T3P3/CurrentLoopControl/README.MD

Control of a 4-20mA current loop with optical isolation by Think3dprint3d and Escher3D

Designed to be connected to Duet Electronics. www.duet3d.com

Licensed under CERN OHL 1.2
