T3P3/CurrentLoopControl/CurrentLoopInterfaceBoard_Schematic_v0.4.pdf

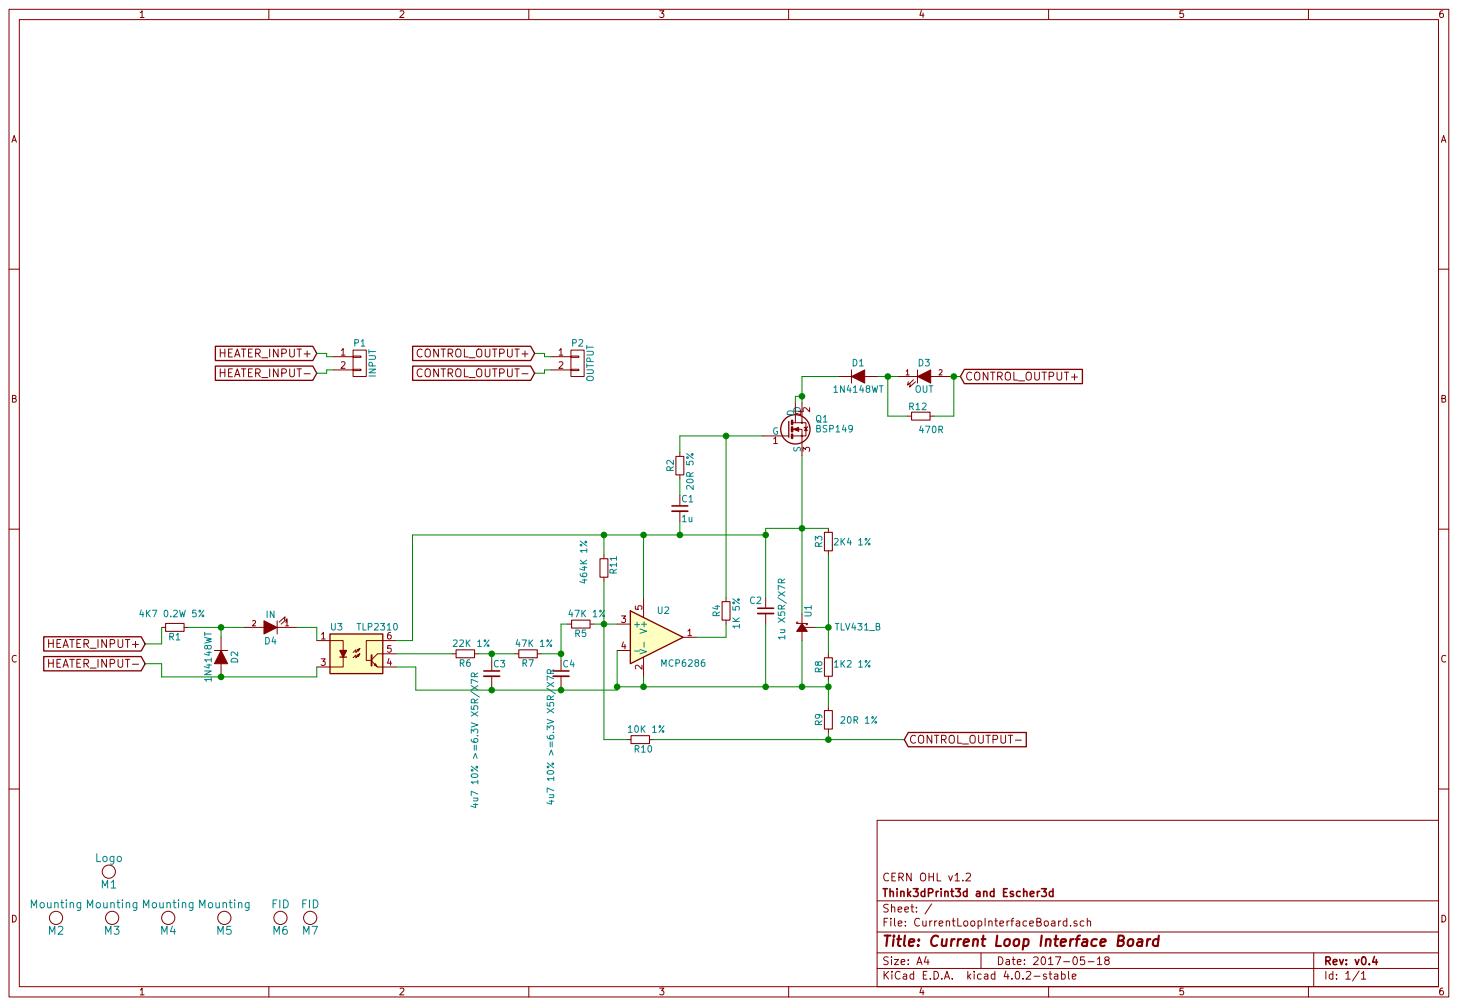
[picture p1: page 1]

File: CurrentLoopInterfaceBoard.sch Sheet: / Think3dPrint3d and Escher3d CERN OHL v1.2

Id: 1/1 Title: Current Loop Interface Board
