T3P3/CurrentLoopControl/CurrentLoopInterfaceBoard.kicad_pcb

## KiCad design CurrentLoopInterfaceBoard.kicad_pcb (2018-03-17)

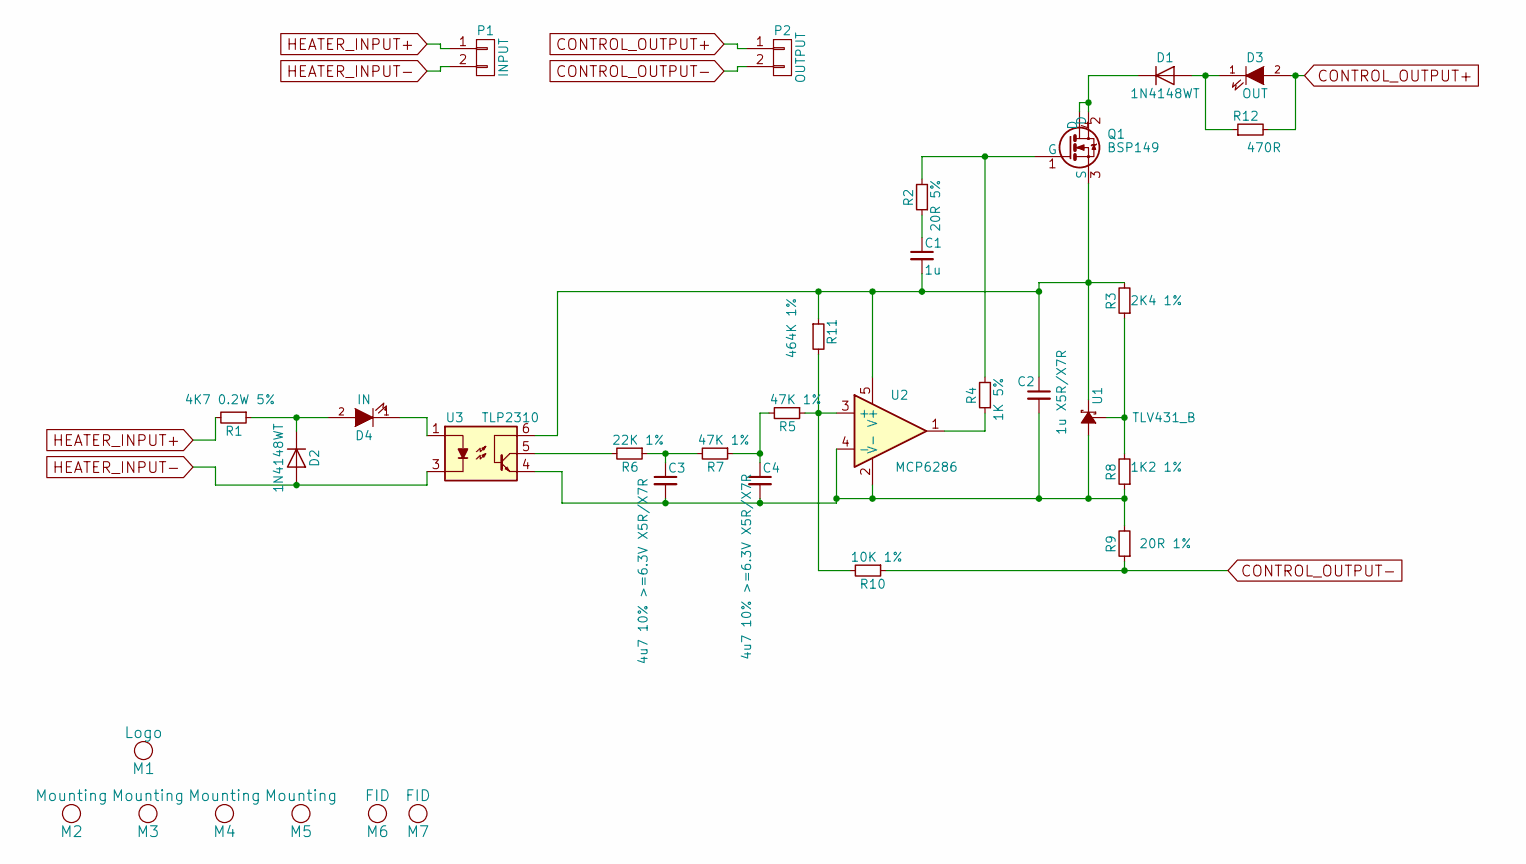
[picture p2: schematic CurrentLoopInterfaceBoard.sch, Current Loop Interface Board]

Parts:
C1: 1u; C_0603
C2: 1u X5R/X7R; C_0603
C3, C4: 4u7 10% >=6.3V X5R/X7R; C_0603
D1, D2: 1N4148WT; D_SOD-123F
D3: OUT; LED_0805
D4: IN; LED_0603
M1: Logo; LOGO_Duet3dCompatible_xs
M2, M3, M4, M5: Mounting; Fixing_M3
M6, M7: FID; Fiducial_1mm_Dia_2.54mm_Outer_CopperTop
P1: INPUT; PIN_ARRAY_2X1
P2: OUTPUT; 3.5MM_2X1
Q1: BSP149; SOT-223
R1: 4K7 0.2W 5%; R_0805
R2: 20R 5%; R_0603
R3: 2K4 1%; R_0603
R4: 1K 5%; R_0603
R5, R7: 47K 1%; R_0603
R6: 22K 1%; R_0603
R8: 1K2 1%; R_0603
R9: 20R 1%; R_0603
R10: 10K 1%; R_0603
R11: 464K 1%; R_0603
R12: 470R; R_0603
U1: TLV431_B; SOT-23
U2: MCP6286; SOT-23-5L
U3: TLP2310; SO6_with_5pins

Connections:
CONTROL_OUTPUT+: D3.2 (A), P2.1, R12.2
CONTROL_OUTPUT-: P2.2, R9.1, R10.1
HEATER_INPUT+: P1.1, R1.2
HEATER_INPUT-: D2.2 (A), P1.2, U3.3
unnamed: C1.1, R2.1
unnamed: C1.2, C2.1, Q1.3 (S), R3.2, R11.1, U1.2 (K), U2.5 (V+), U3.6
unnamed: C2.2, C3.2, C4.2, R8.1, R9.2, U1.3 (A), U2.2 (V-), U2.4 (-), U3.4
unnamed: C3.1, R6.1, R7.2
unnamed: C4.1, R5.2, R7.1
unnamed: D1.1 (K), Q1.2 (D), Q1.4 (D)
unnamed: D1.2 (A), D3.1 (K), R12.1
unnamed: D2.1 (K), D4.2 (A), R1.1
unnamed: D4.1 (K), U3.1
unnamed: Q1.1 (G), R2.2, R4.2
unnamed: R3.1, R8.2, U1.1 (Ref)
unnamed: R4.1, U2.1
unnamed: R6.2, U3.5
unnamed: R5.1, R10.2, R11.2, U2.3 (+)

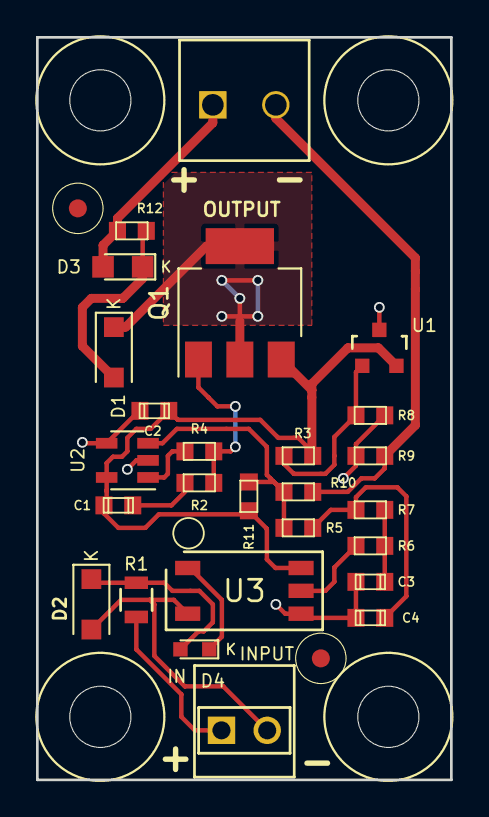
[picture p3: board CurrentLoopInterfaceBoard.kicad_pcb from above]

Board: 2 copper layers, 23.0 x 41.2 mm, 33 parts (1 on the bottom side), 18 nets.
